satouhfares/foldedOTA-sg13g2/theory/classic_cascode_current_mirror.png

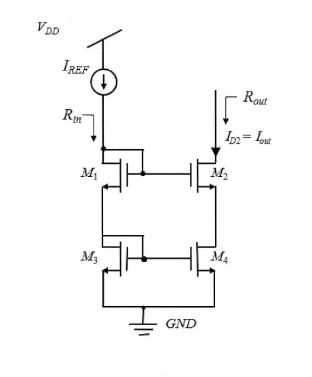
theory/classic_cascode_current_mirror.png
