satouhfares/foldedOTA-sg13g2/theory/low_voltage_cascode_current_mirror.png

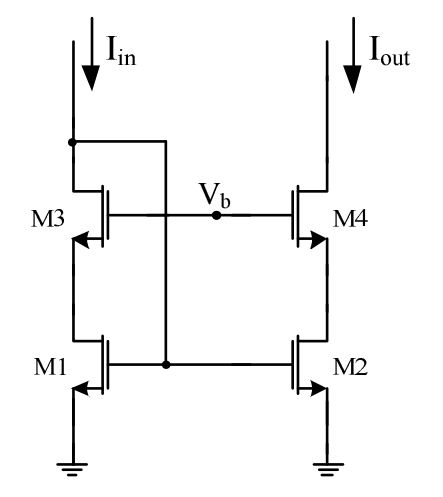
theory/low_voltage_cascode_current_mirror.png
