satouhfares/foldedOTA-sg13g2/v1_ideal_current_sources/ac/ACresponse.png

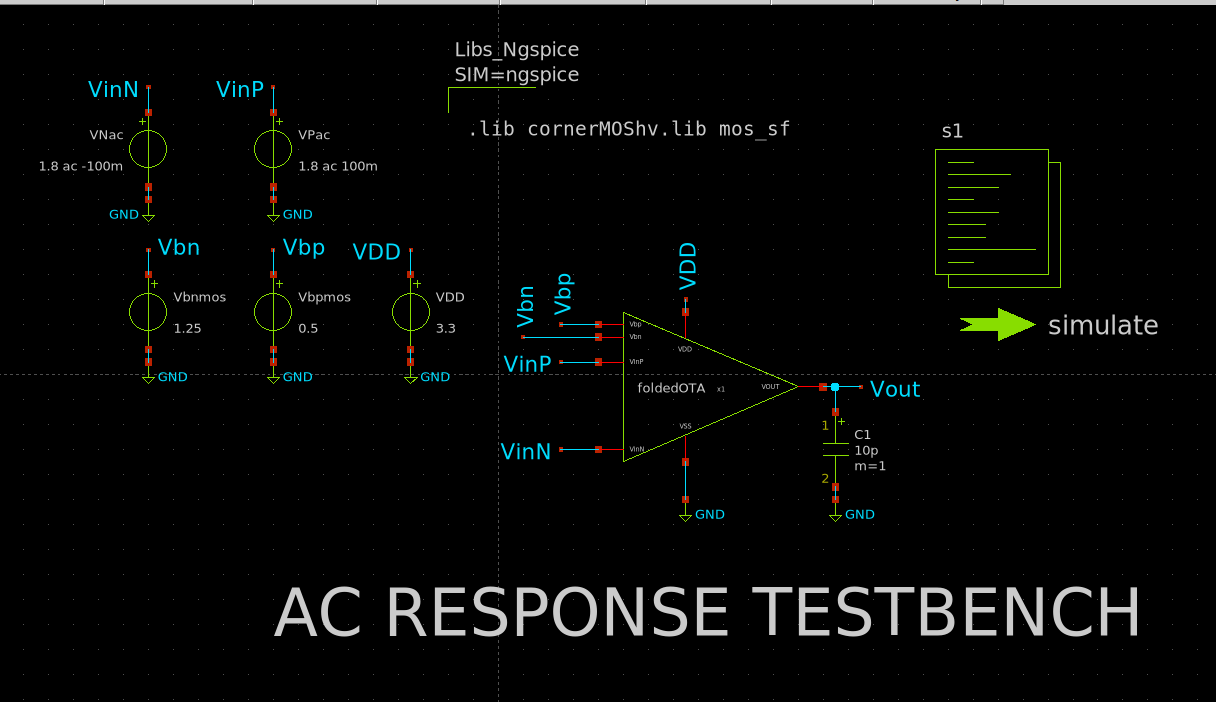
v1_ideal_current_sources/ac/ACresponse.png
