satouhfares/foldedOTA-sg13g2/v1_ideal_current_sources/ac/OpenLoopGain.png

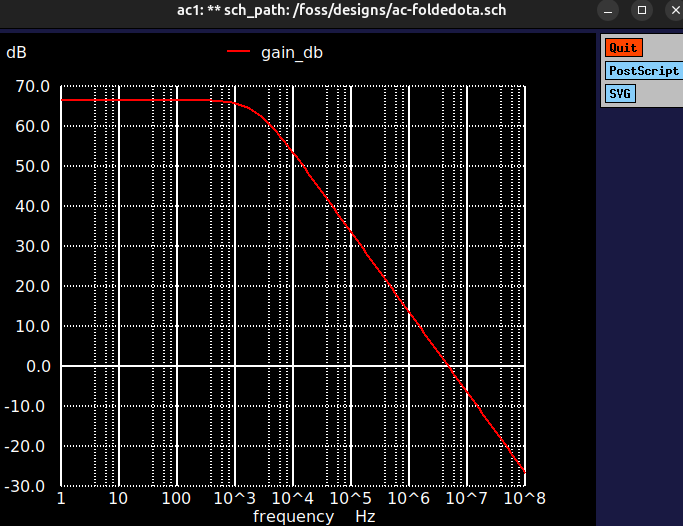
v1_ideal_current_sources/ac/OpenLoopGain.png
