satouhfares/foldedOTA-sg13g2/v1_ideal_current_sources/closedloop/ClosedLoopGain.png

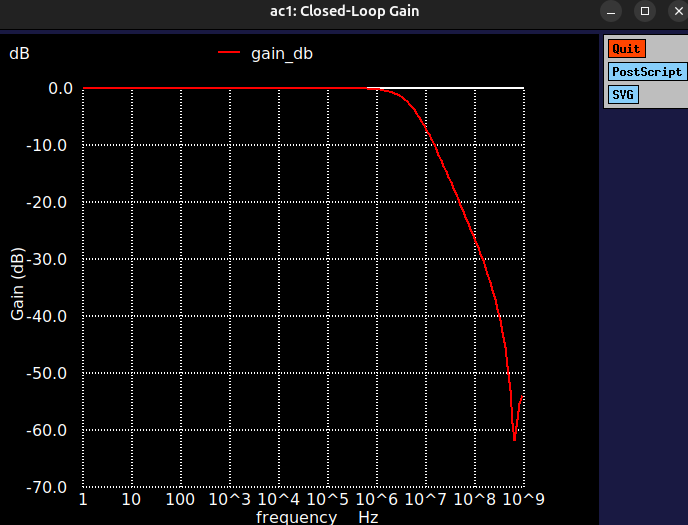
v1_ideal_current_sources/closedloop/ClosedLoopGain.png
