satouhfares/foldedOTA-sg13g2/v1_ideal_current_sources/closedloop/ClosedLoopTB.png

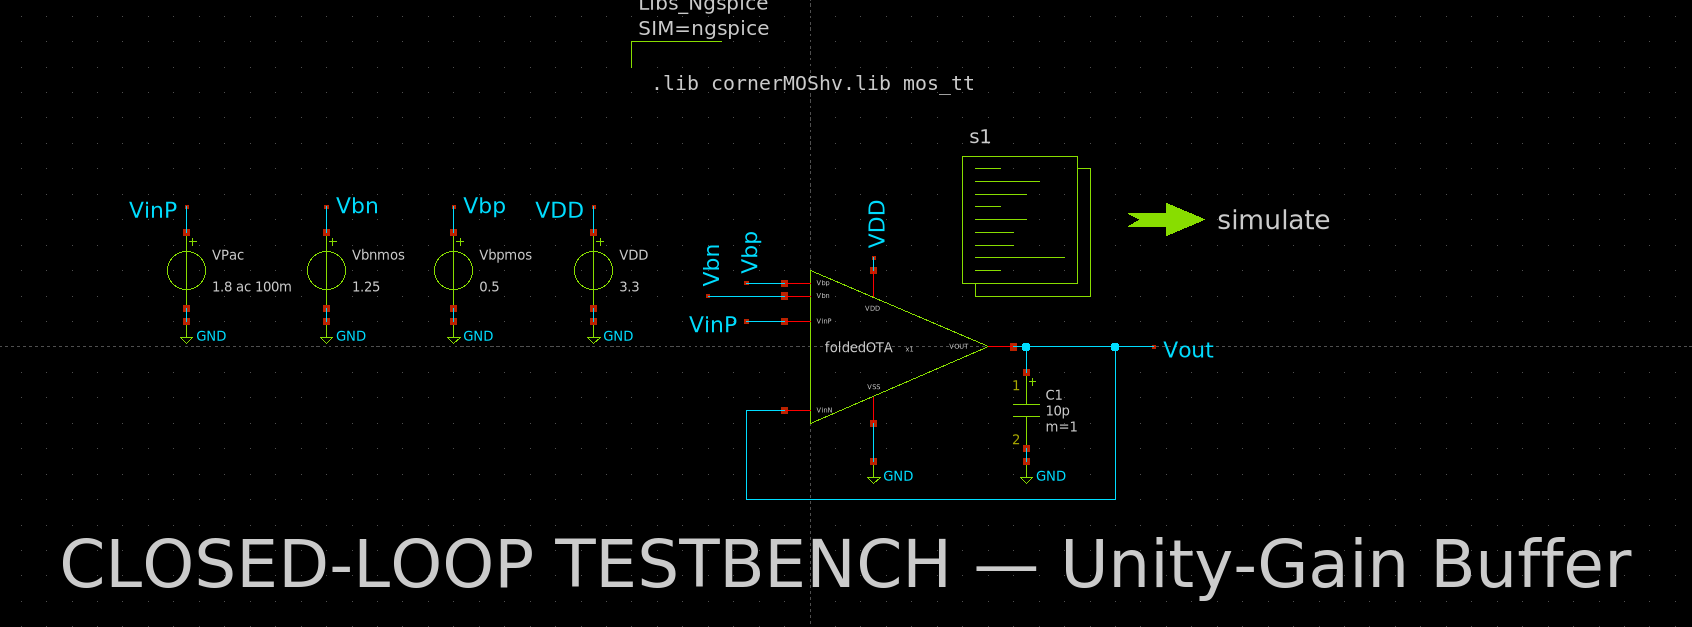
v1_ideal_current_sources/closedloop/ClosedLoopTB.png
