satouhfares/foldedOTA-sg13g2/v1_ideal_current_sources/cmrr/cmrr_plot.png

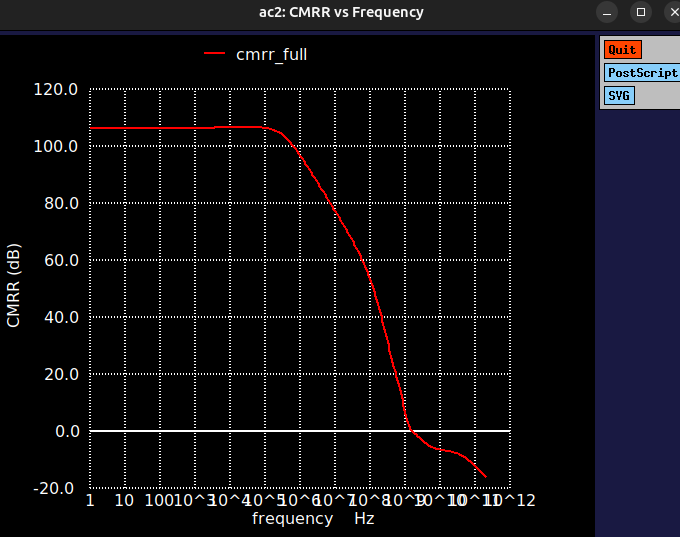
v1_ideal_current_sources/cmrr/cmrr_plot.png
