satouhfares/foldedOTA-sg13g2/v1_ideal_current_sources/psrr/PSRRnTB.png

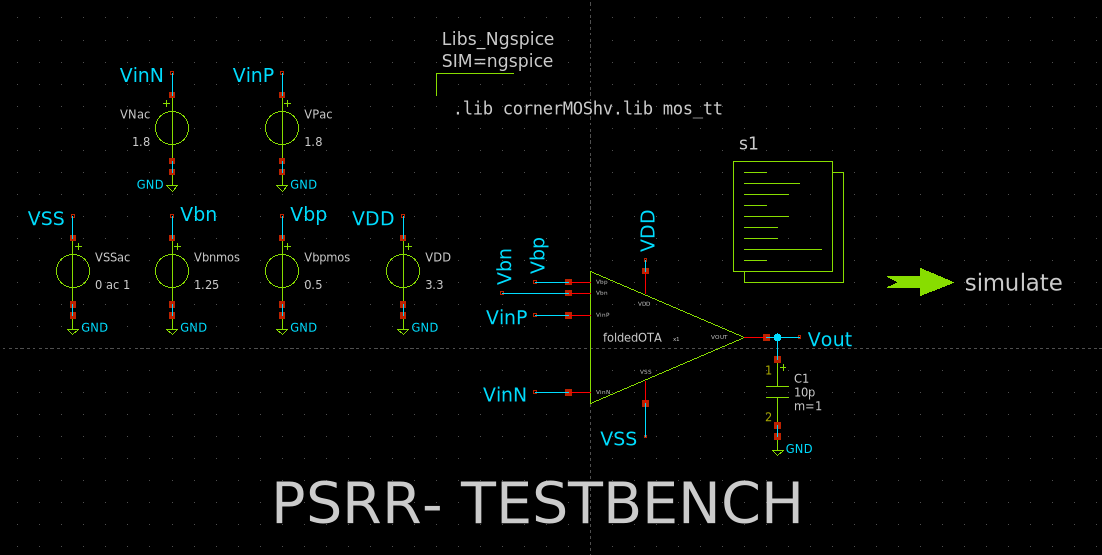
v1_ideal_current_sources/psrr/PSRRnTB.png
