satouhfares/foldedOTA-sg13g2/v1_ideal_current_sources/psrr/PSRRpTB.png

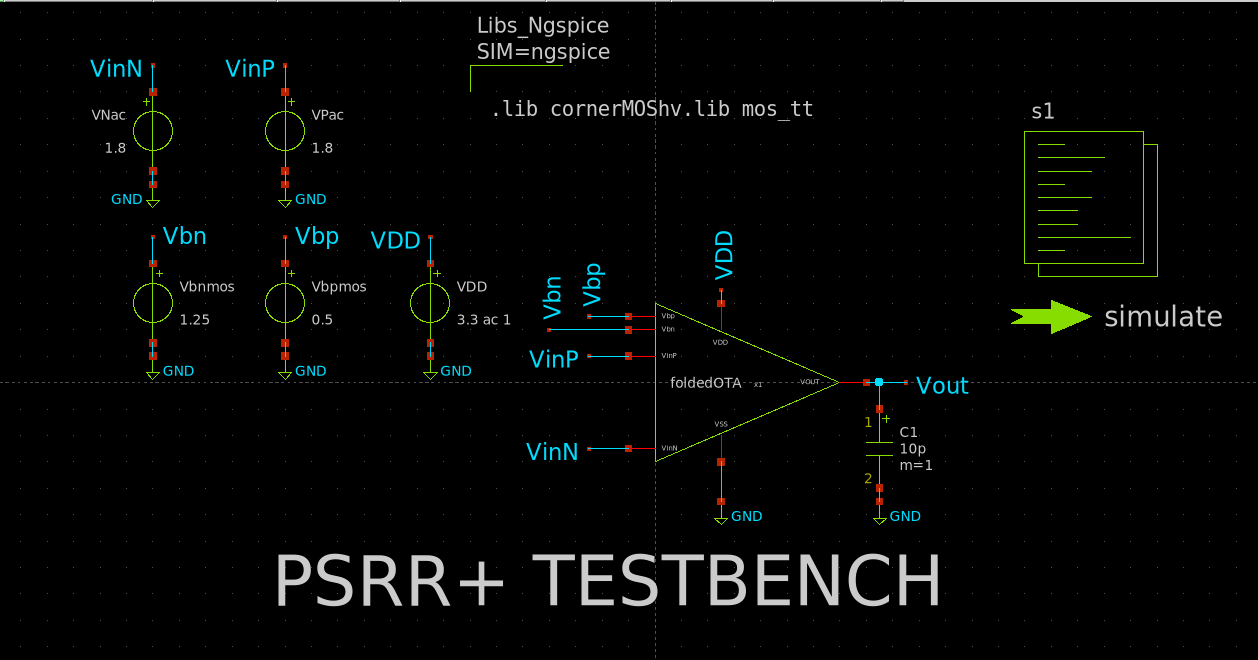
v1_ideal_current_sources/psrr/PSRRpTB.png
