satouhfares/foldedOTA-sg13g2/v1_ideal_current_sources/schematic/folded_cascode_sch.png

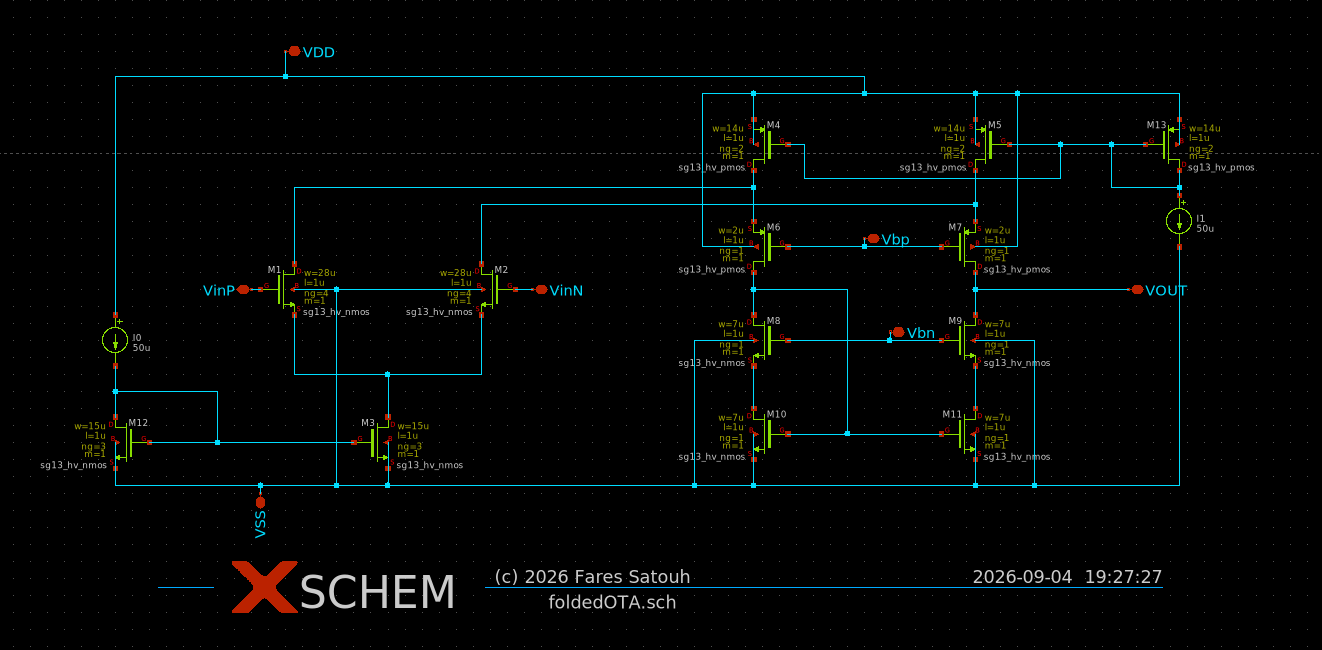
v1_ideal_current_sources/schematic/folded_cascode_sch.png
