satouhfares/foldedOTA-sg13g2/v1_ideal_current_sources/slew_rate/SlewRateTB.png

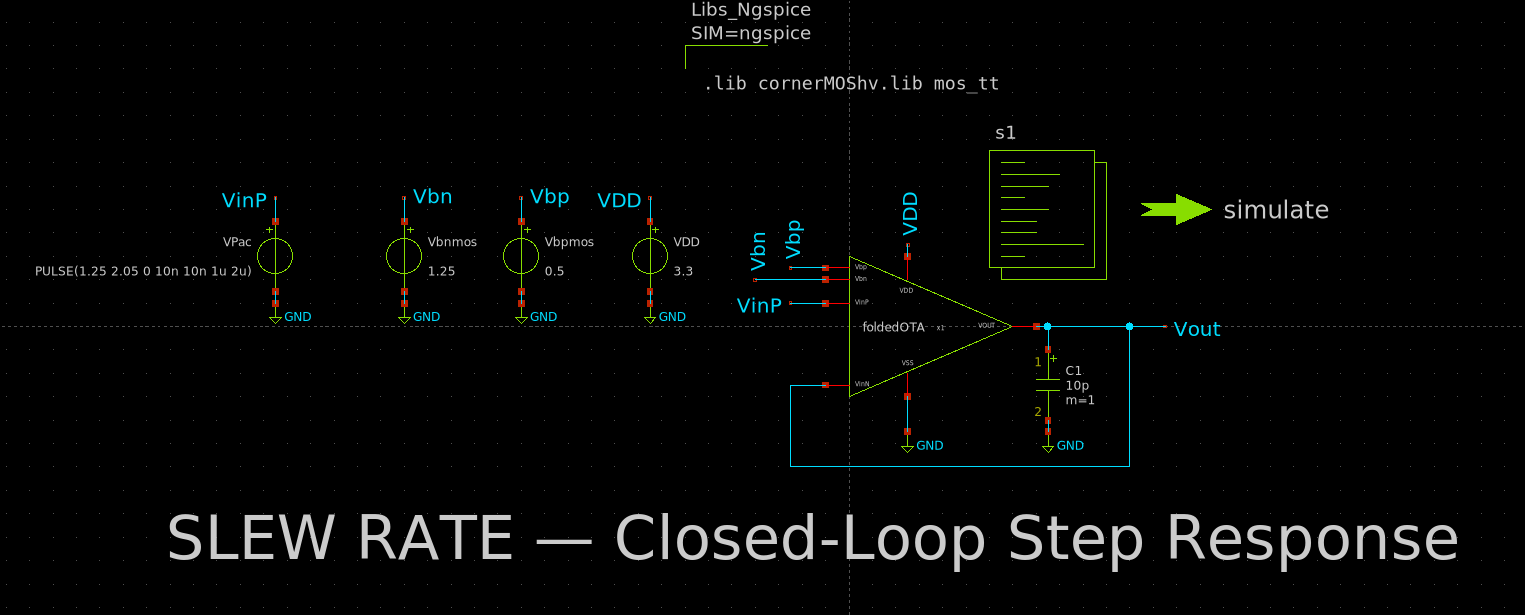
v1_ideal_current_sources/slew_rate/SlewRateTB.png
